jacek27/wemos_open_therm/bot.pdf

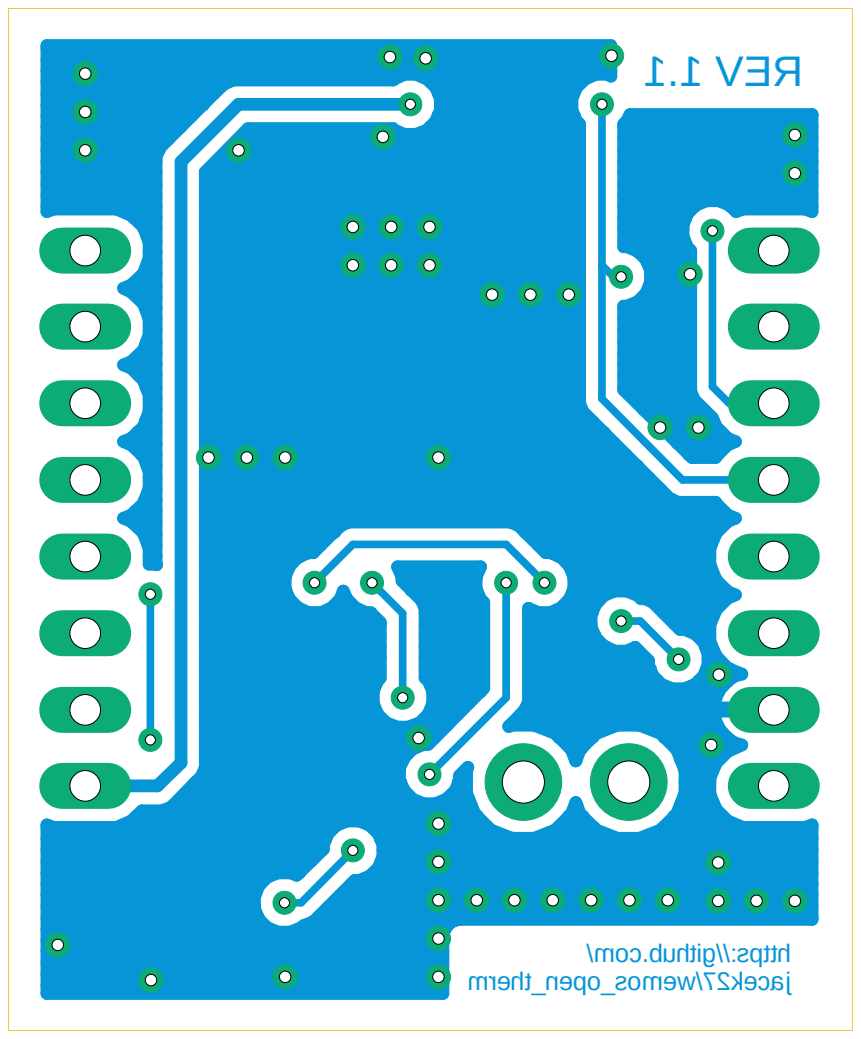
[picture p3: page 1]
jacek27/wemos_open_therm; REV 1.1

https://github.com/
