jacek27/wemos_open_therm/sch.pdf

# R1 R² R³

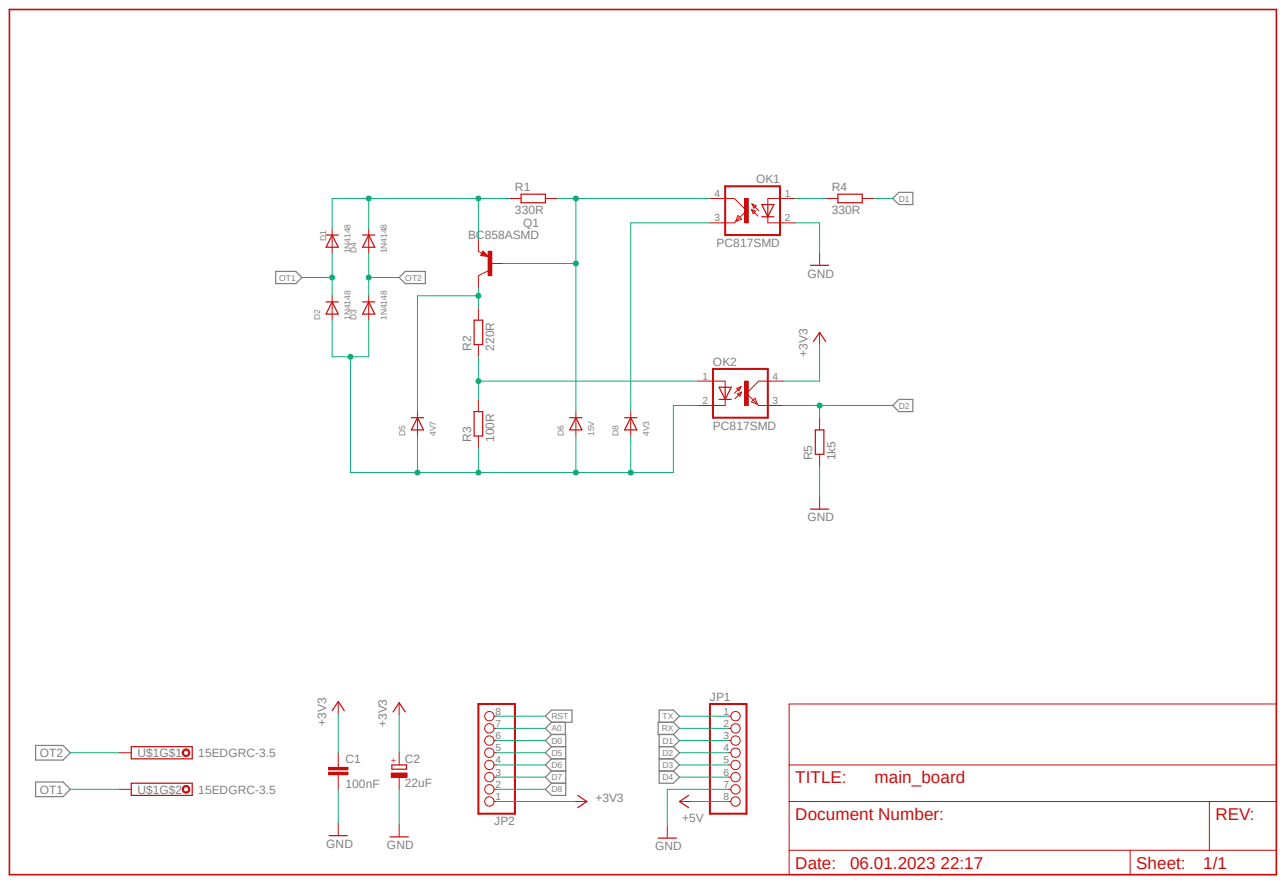
[picture p4: page 1]

Document Number: | REV:

Date: 06.01.2023 22:17 | Sheet: 1/1
