jacek27/wemos_open_therm/top.pdf

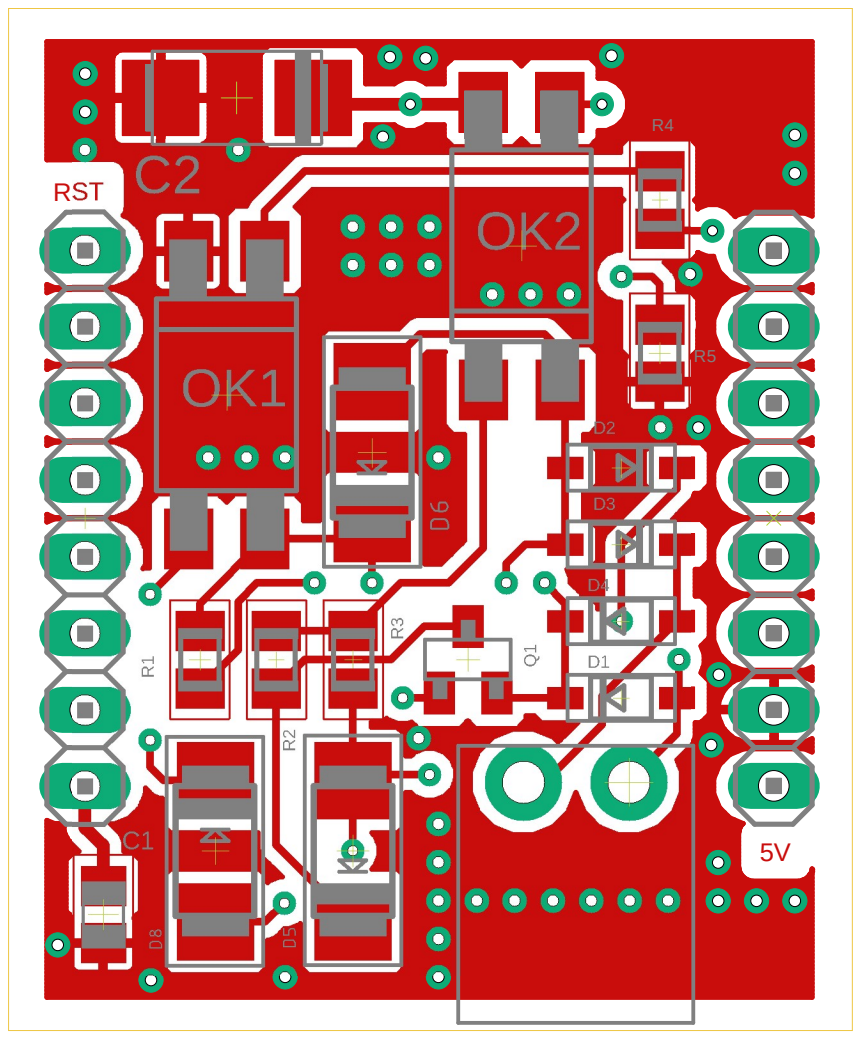
[picture p5: page 1]
RST
