jacek27/wemos_open_therm/main_board.sch

## EAGLE design main_board.sch (2023-01-06)

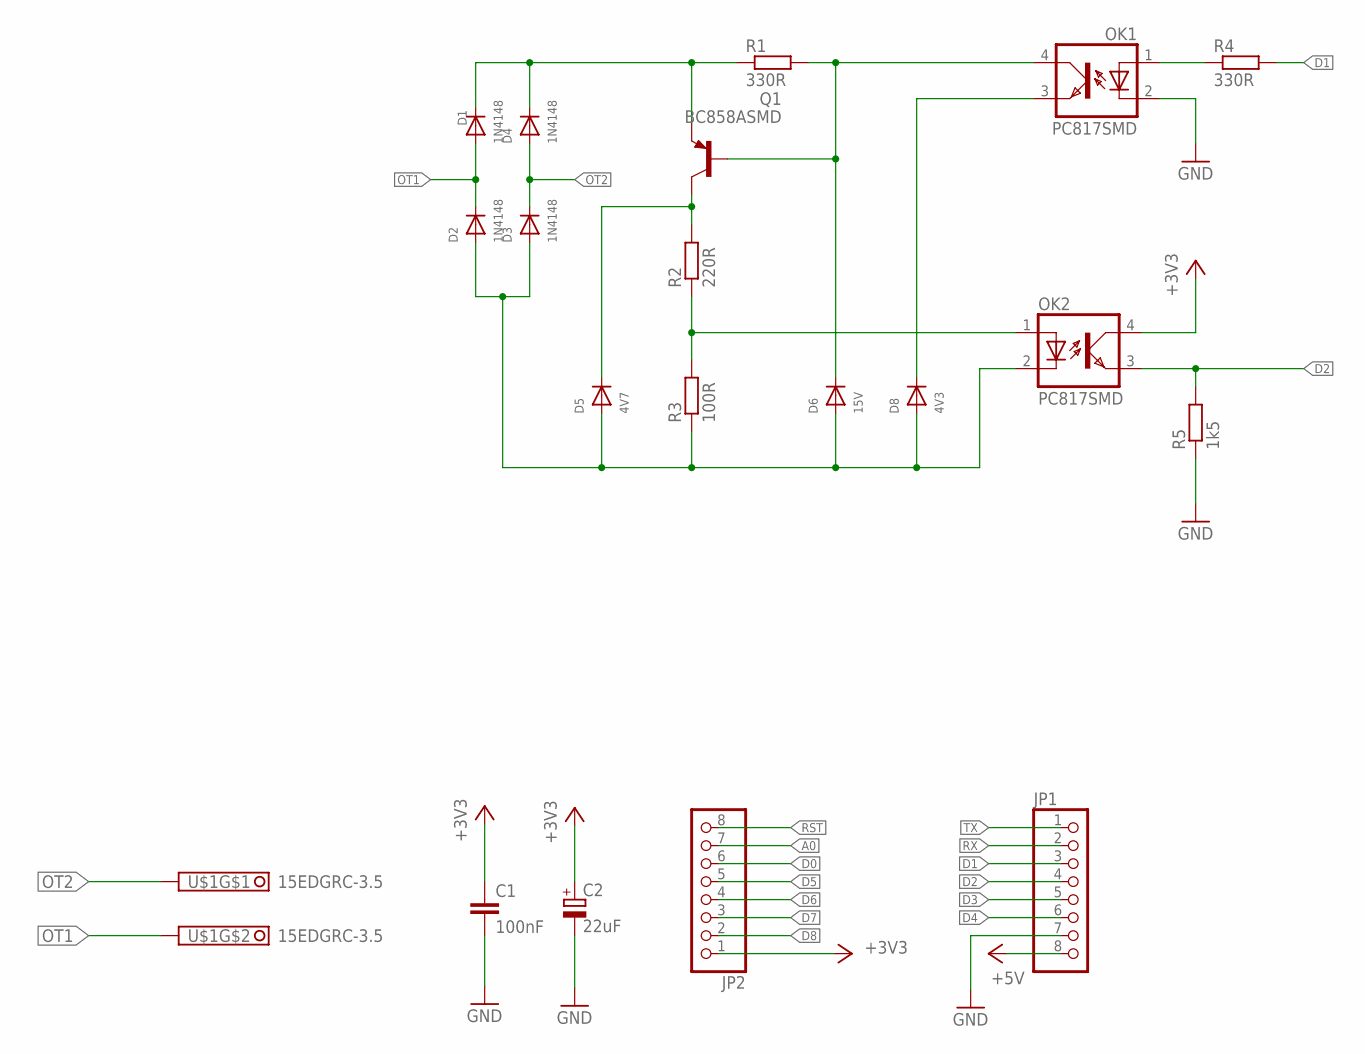
[picture p6: schematic main_board.sch]

Parts:
C1: 100nF; C0805
C2: 22uF; C/6032-28R
D1, D2, D3, D4: 1N4148; SOD-123
D5: 4V7; SMADIODE
D6: 15V; SMADIODE
D8: 4V3; SMADIODE
JP1, JP2: PINHD-1X8; 1X08
OK1, OK2: PC817SMD; DIL4-SMD
Q1: BC858ASMD; SOT23-BEC
R1, R4: 330R; M0805
R2: 220R; M0805
R3: 100R; M0805
R5: 1k5; M0805
U$1: 15EDGRC-3.5; 15EDGRC-3.5/2P

Connections:
+3V3: C1.1, C2.+, JP2.1, OK2.4 (COL)
+5V: JP1.8
A0: JP2.7
D0: JP2.6
D1: JP1.3, R4.2
D2: JP1.4, OK2.3 (EMIT), R5.2
D3: JP1.5
D4: JP1.6
D5: JP2.5
D6: JP2.4
D7: JP2.3
D8: JP2.2
GND: C1.2, C2.-, JP1.7, OK1.2 (C), R5.1
unnamed: D2.A, D3.A, D5.A, D6.A, D8.A, OK2.2 (C), R3.1
unnamed: D1.C, D4.C, Q1.E, R1.1
unnamed: D8.C, OK1.3 (EMIT)
unnamed: OK2.1 (A), R2.1, R3.2
unnamed: D5.C, Q1.C, R2.2
unnamed: D6.C, OK1.4 (COL), Q1.B, R1.2
unnamed: OK1.1 (A), R4.1
OT1: D1.A, D2.C, U$1.P$4
OT2: D3.C, D4.A, U$1.P$3
RST: JP2.8
RX: JP1.2
TX: JP1.1
